rbingham97/IDD_HologramProject/hologram.ino

/* Rotary encoder test code
 * Modified from http://www.circuitsathome.com/mcu/programming/reading-rotary-encoder-on-arduino by Oleg
 * Latest mod by Jessica Faruque 7/17/2013
 */
 
 
#define ENC_A 6 //these need to be digital input pins
#define ENC_B 7
#define PWM_PIN 9
#define BUTTON_PIN A5

#define PWMmax 200
#define PWMmin 10

int pwmVal = 100;
bool lastPress = false;
 
void setup()
{
  /* Setup encoder pins as inputs */
  pinMode(ENC_A, INPUT_PULLUP);
  pinMode(ENC_B, INPUT_PULLUP);
  pinMode(PWM_PIN, OUTPUT);
 
  Serial.begin (9600);
  Serial.println("Start");

  
}
 
void loop()
{
  
  static unsigned int counter4x = 0;      //the SparkFun encoders jump by 4 states from detent to detent
  static unsigned int counter = 0;
  static unsigned int prevCounter = 0;
  int tmpdata;
  tmpdata = read_encoder();
  if( tmpdata) {
    counter4x += tmpdata;
    counter = counter4x/4;
    if (prevCounter != counter){
      if (counter > prevCounter) {
        if (pwmVal <= PWMmax-10) {
          pwmVal = pwmVal + 10;
        }
      }
      else {
        if (pwmVal >= PWMmin+10) {
          pwmVal = pwmVal - 10;
        }
      }
    }
    
    analogWrite(PWM_PIN, pwmVal);
    Serial.println(pwmVal);
    prevCounter = counter;

    // button read, Pi comms NYI
    if (analogRead(BUTTON_PIN) > 500 & !lastPress) {
      //send message to Pi
      Serial.println("Button Press");
      lastPress = true;
    }
    else {
      lastPress = false;
    }
  }
}
 
/* returns change in encoder state (-1,0,1) */
int read_encoder()
{
  static int enc_states[] = {
    0,-1,1,0,1,0,0,-1,-1,0,0,1,0,1,-1,0  };
  static byte ABab = 0;
  ABab *= 4;                   //shift the old values over 2 bits
  ABab = ABab%16;      //keeps only bits 0-3
  ABab += 2*digitalRead(ENC_A)+digitalRead(ENC_B); //adds enc_a and enc_b values to bits 1 and 0
  return ( enc_states[ABab]);
 
 
}
